sbkeebs/clipper/case/README.md

### note
Plate files have been updated and clipper_plate2.stl/step are the newest ones. These incorporate the design from pixls' tight fit plate and wider holes for m3 screws. The plate is still "tight fit" style for smaller print beds.
