sbkeebs/clipper/case/clipper_plate2.step

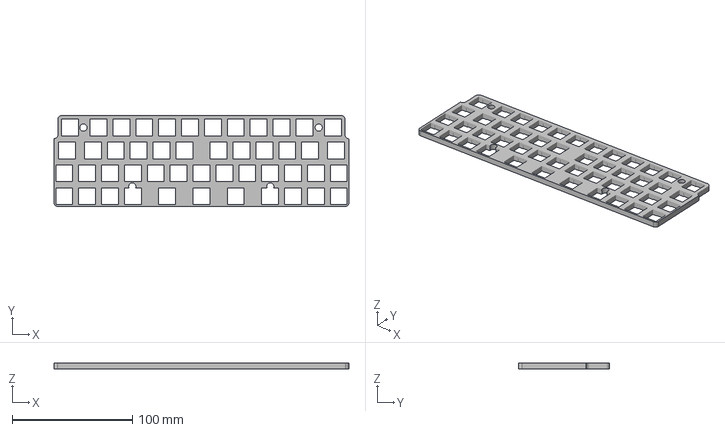
[picture p1: CAD file, 2025-01-26]
case/clipper_plate2.step
245.7 x 75.7 x 4.75 mm
