sbkeebs/clipper/case/clipper plate tight fit.stl

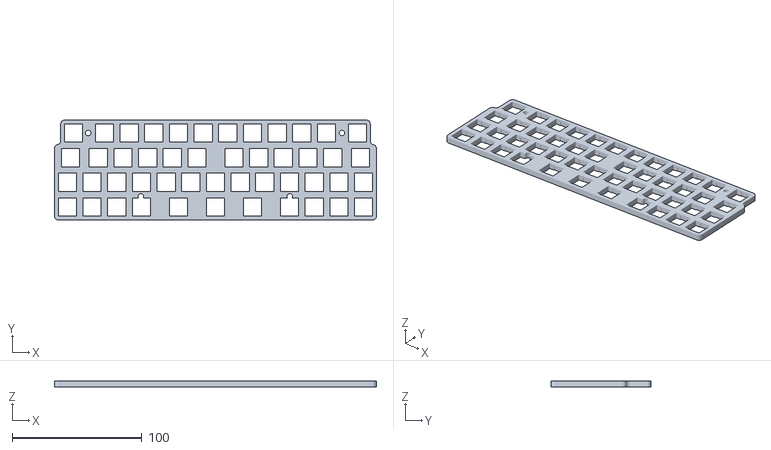
[picture p2: CAD file, 2025-01-13]
case/clipper plate tight fit.stl
248.6 x 77.2 x 4.75
