sbkeebs/clipper/case/clipper_boop_tray.stl

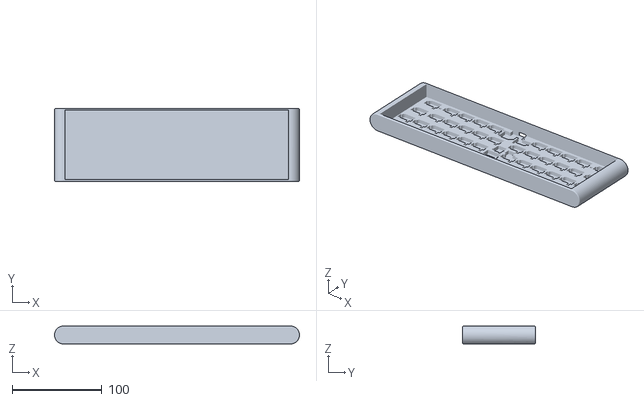
[picture p3: CAD file, 2025-01-13]
case/clipper_boop_tray.stl
272.7 x 81.3 x 20.0
