sbkeebs/clipper/case/case_bottom.step

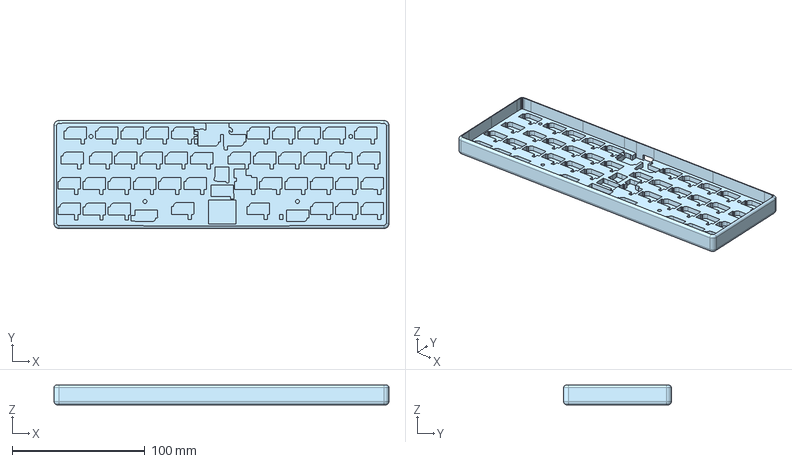
[picture p4: CAD file, 2025-01-09]
case/case_bottom.step
252.7 x 81.3 x 15.0 mm
