sbkeebs/clipper/case/outer_case.step

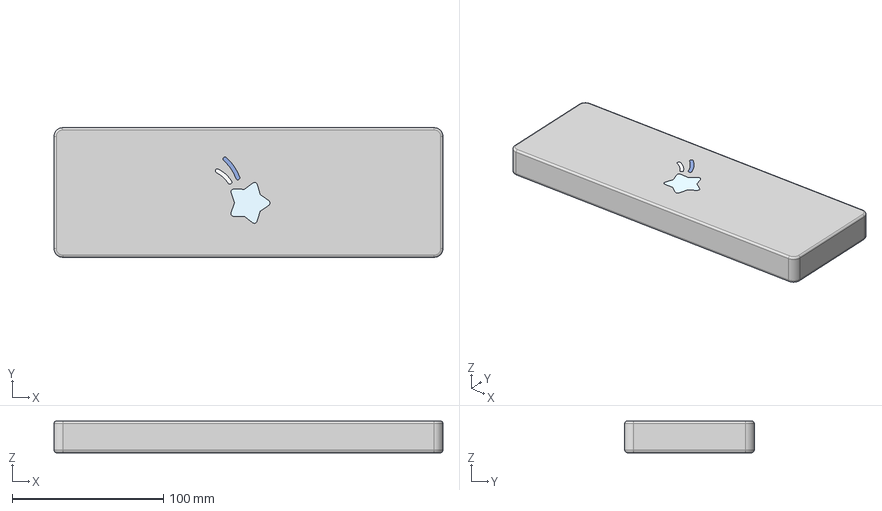
[picture p5: CAD file, 2025-01-09]
case/outer_case.step
257.1 x 85.7 x 21.0 mm
