sbkeebs/clipper/case/clipper_plate.step

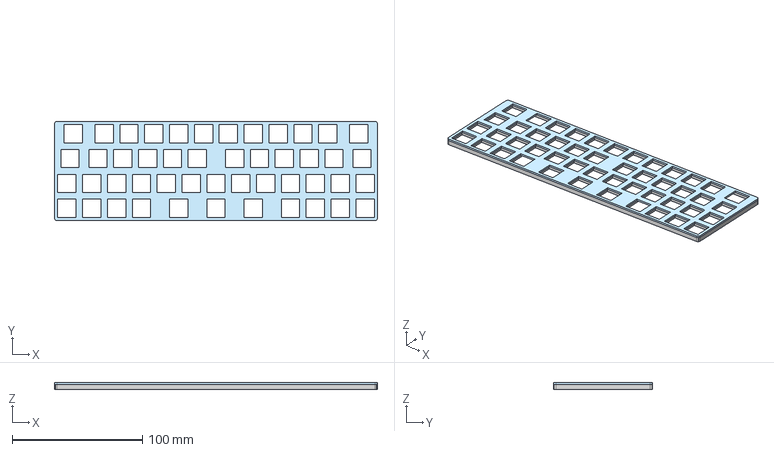
[picture p6: CAD file, 2025-01-09]
case/clipper_plate.step
247.6 x 76.2 x 5.00 mm
