sbkeebs/clipper/(list of files, cad)

Other CAD files:
case/case_bottom.stl
case/clipper_plate.stl
case/clipper_plate2.stl
case/outer_case.stl
