sbkeebs/clipper/vial_firmware/keymaps/vial/config.h

/*
Copyright 2021 xxxxxxxxxxxxxxx
This program is free software: you can redistribute it and/or modify
it under the terms of the GNU General Public License as published by
the Free Software Foundation, either version 2 of the License, or
(at your option) any later version.
This program is distributed in the hope that it will be useful,
but WITHOUT ANY WARRANTY; without even the implied warranty of
MERCHANTABILITY or FITNESS FOR A PARTICULAR PURPOSE.  See the
GNU General Public License for more details.
You should have received a copy of the GNU General Public License
along with this program.  If not, see <http://www.gnu.org/licenses/>.
*/

#pragma once

/* VIAL Specific definitions */
#define VIAL_KEYBOARD_UID {0x3C, 0x01, 0xE0, 0x60, 0x3A, 0xEC, 0xB2, 0xF5}
#define VIAL_UNLOCK_COMBO_ROWS { 0, 0 }
#define VIAL_UNLOCK_COMBO_COLS { 0, 12 }
#define MATRIX_ROWS 4
#define MATRIX_COLS 13
