sbkeebs/clipper/(commit log)

2025-01-09 add case files
    [case_bottom.step, case_bottom.stl, clipper_plate.step, clipper_plate.stl, outer_case.step, outer_case.stl]
2025-01-09 add kicad files
    [bom.csv, clipper.kicad_pcb, clipper.kicad_sch, designators.csv, matrix.kicad_sch, positions.csv]
2025-01-13 add boop version
    [clipper_boop_tray.stl]
2025-01-13 add clipper plate for smaller print beds
    [clipper plate tight fit.stl]
2025-01-26 upload updated plate files
    [clipper_plate2.step, clipper_plate2.stl]
2025-01-26 plate readme
